KonradMerkel/Moskito/README.md

Moskito
=======

Mathematische Beschreibung und technische Umsetzung eines Multifunktionsgerätes namens Moskito mithilfe eines Mikrocontrollers und systemübergreifender Programmierung

=======

Dies ist ein Jugend-Forscht-Projekt. Die schriftliche Arbeit ist in der Datei Moskito.pdf einzusehen.
Der Quellcode des Arduino-Mikrocontrollers befindet sich im Unterordner Arduino. Die Anwenderprogramme sind jeweils in den Ordnern WALL und MoskitoGUI. Die Entwicklerschnittstelle, sowie andere Bibliotheken sind unter lib gespeichert.

Beim Lesen und Nachvollziehen des Quelltextes ist es empfehlenswert mit der Datei Arduino/Moskito/Moskito.ino anzufangen.
