KonradMerkel/Moskito/tests/ultraschall/Messreihe_14-03-19.ods

Temperatur [°C] | 17.9
tatsächlicher Abstand [cm] | gemessener Abstand [cm] | gemessener Abstand [cm] | Durchschnitt
