KonradMerkel/Moskito/tests/ultraschall/Messreihe_14-02-28.ods

Temperatur [°C] | 17,9 |  |  | delayMicroseconds(100000); digitalWrite(ULTRA_TRIG, HIGH); DelayMicroseconds(1);
tatsächlicher Abstand [cm] | gemessener Abstand [cm] | gemessener Abstand [cm] | Durchschnitt
5 | 4,55 | 4,54 | 4,545 |  | Regression: | linear | f(x) = 1,27687719*x -2,1481228 | ←
6 | 5,64 | 5,63 | 5,635 |  |  | x² | f(x) = 3,4962e-3 * x² + 1,17898245*x – 1,5677468 | ←
7 | 6,92 | 6,92 | 6,92 |  |  | ln x | f(x) = 15,3323012 * ln(x) – 23351958
8 | 7,71 | 7,72 | 7,715 |  |  | exp | f(x) = 3,76246935 * e^(0,09347289 * x)
9 | 9,42 | 9,42 | 9,42 |  |  | logistic | f(x) = 33,7389961 / (1+12,6035179 * e^(-0,16947391 * x)) | ←
10 | 10,74 | 10,74 | 10,74
11 | 11,48 | 11,48 | 11,48
12 | 13,17 | 13,15 | 13,16
13 | 14,58 | 14,6 | 14,59
14 | 15,66 | 15,67 | 15,665
15 | 16,67 | 16,67 | 16,67
16 | 18,42 | 18,41 | 18,415
17 | 19,26 | 19,27 | 19,265
18 | 20,97 | 20,94 | 20,955
19 | 21,87 | 21,91 | 21,89
20 | 23,48 | 23,48 | 23,48
21 | 24,92 | 24,92 | 24,92
22 | 26,26 | 26,28 | 26,27
23 | 27,1 | 27,1 | 27,1
24 | nan | nan | nan
Temperatur [°C] | 18 |  |  | delayMicroseconds(2);
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
