KonradMerkel/Moskito/tests/ultraschall/Messreihe_14-03-22.ods

Temperatur [°C] | 20 | 19.7
tatsächlicher Abstand [cm] | gemessener Abstand [cm] | Spannweite [cm] | zweite Messung Abstand [cm] | Spannweite [cm] | Durchschnitt [cm] | Durchschinttliche Spannweite [cm]
14.5 | 17.66 | 1.31 | 17.62 | 1.45
15.5 | 18.79 | 2.05 | 18.69 | 1.45
16.5 | 20.01 | 1.29 | 19.85 | 1.29
17.5 | 21.2 | 1.77 | 21.27 | 1.15
18.5 | 22.94 | 1.03 | 23.1 | 1.14
19.5 | 23.56 | 1.72 | 23.37 | 2.42
20.5 | 25.27 | 1.44 | 24.99 | 1.72
21.5 | 26.92 | 1.31 | 26.65 | 1.6
22.5 | 27.9 | 1.32 | 27.7 | 1.31
23.5 | 29.58 | 1.72 | 29.43 | 1.65
24.5 | 29 | 5.29 | 28.28 | 5.99
