KonradMerkel/Moskito/MoskitoGUI/testBild.jpg

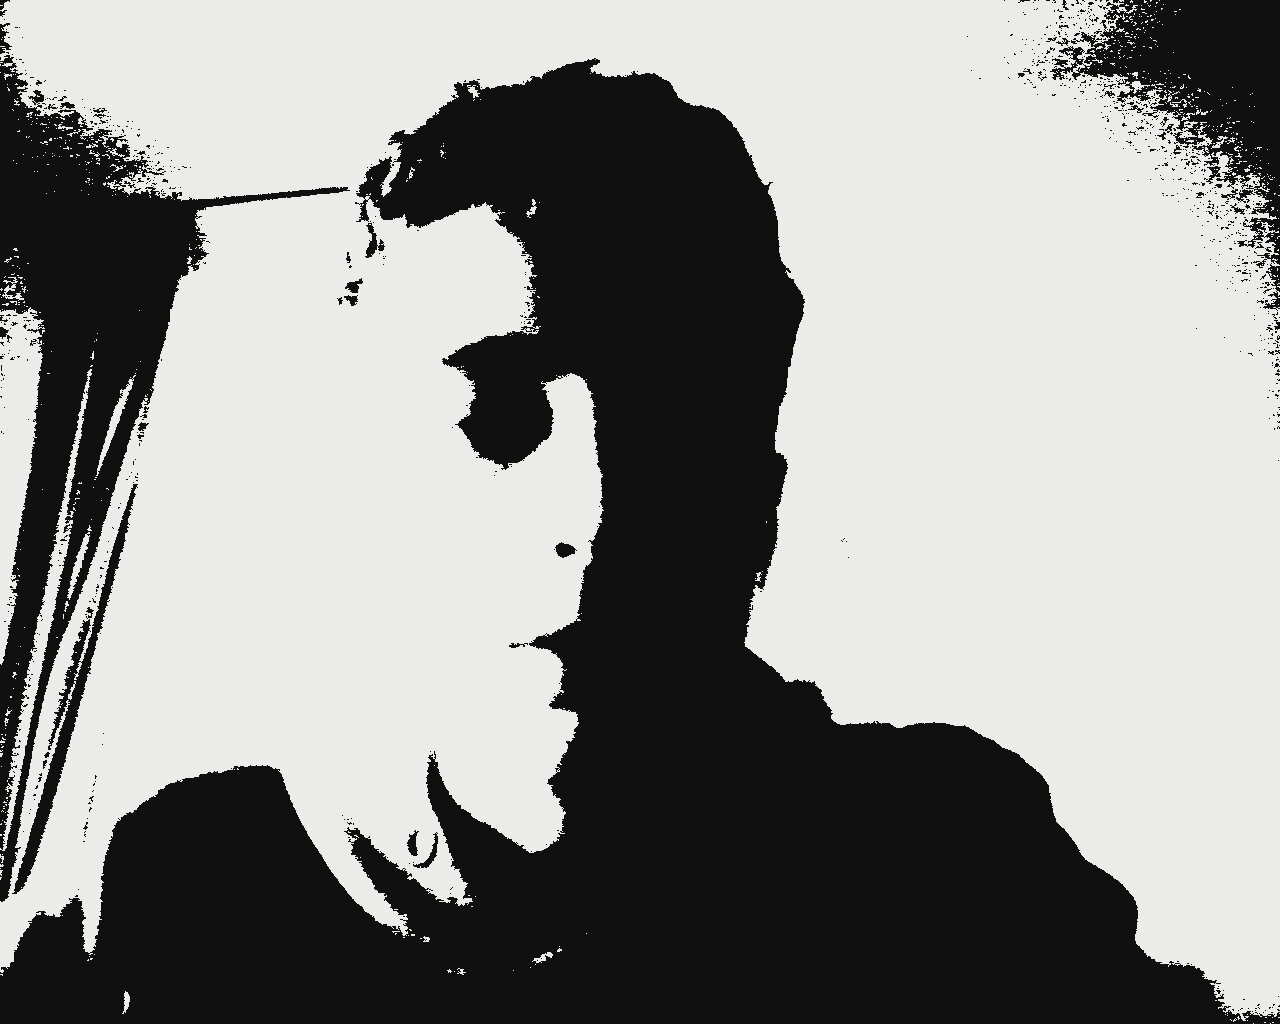
MoskitoGUI/testBild.jpg
