KonradMerkel/Moskito/Arduino/Moskito/morse_mod.h

/************************************************************
		       Morse-Code - Funktionen
*************************************************************/
#ifndef MORSE_MOD_H
#define MORSE_MOD_H

/* Bemerkung:
** Diese Datei beinhaltet kein Modul, sondern nur einige Funktionen.
** Aufgrund der Länge der Funktionen besitzen diese dennoch ihre
** eigene Datei. Das Unterschied zur einem Modul besteht darin, dass
** es keine runtime()- Funktion gibt.
** Weiterhin kann während des sendens einer Morsenachricht nicht vom
** Gerät erledigt werden.
*/

#include <Arduino.h>

void morse_lang()
{
  laser_switch(true);
  delay(lang);
  laser_switch(false);
  delay(lang);
}
void morse_kurz()
{
  laser_switch(true);
  delay(kurz);
  laser_switch(false);
  delay(kurz);
}

void morse(String str)
{
  #if MOSKITO_SERIAL_DEBUGGING
  Serial.println("beginne zu morsen");
  #endif
  if (str == "") {return;}
  for (int i=0; i < str.length(); i++)
  {
    switch ((char)str[i]){
      case ' ':
        delay(EndOfWord);
        break;
      case 1:
        morse_kurz();
        morse_lang();
        morse_lang();
        morse_lang();
        morse_lang();
        delay(EndOfChar);
        break;
      case 2:
        morse_kurz();
        morse_kurz();
        morse_lang();
        morse_lang();
        morse_lang();
        delay(EndOfChar);
        break;
      case 3:
        morse_kurz();
        morse_kurz();
        morse_kurz();
        morse_lang();
        morse_lang();
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
        break;
      case 'X': case 'x':
        morse_lang();
        morse_kurz();
        morse_kurz();
        morse_lang();
        delay(EndOfChar);
        break;
      case 'Y': case 'y':
        morse_lang();
        morse_kurz();
        morse_lang();
        morse_lang();
        delay(EndOfChar);
        break;
      case 'Z': case 'z':
        morse_lang();
        morse_lang();
        morse_kurz();
        morse_kurz();
        delay(EndOfChar);
        break;
      default:
        delay(EndOfChar);
        break;
    }
  }
}

#endif // MORSE_MOD_H
