KonradMerkel/Moskito/(commit log)

2014-01-24 Infrastruktur und Bugfix
2014-02-22 Ultraschall-Abstandssensor implementiert & Bugfix
    [Moskito.ino, main.cpp, mainwindow.cpp, mainwindow.h, servo_usb_mod.h, settings.cpp, settings.h]
2014-03-23 Ultraschallsupport verbessert & Bugfix
    [Messreihe_14-02-28.ods, Messreihe_14-03-19.ods, Messreihe_14-03-22.ods]
